mhaftarc/pcb_project_mh/docs/plytkamh.pdf

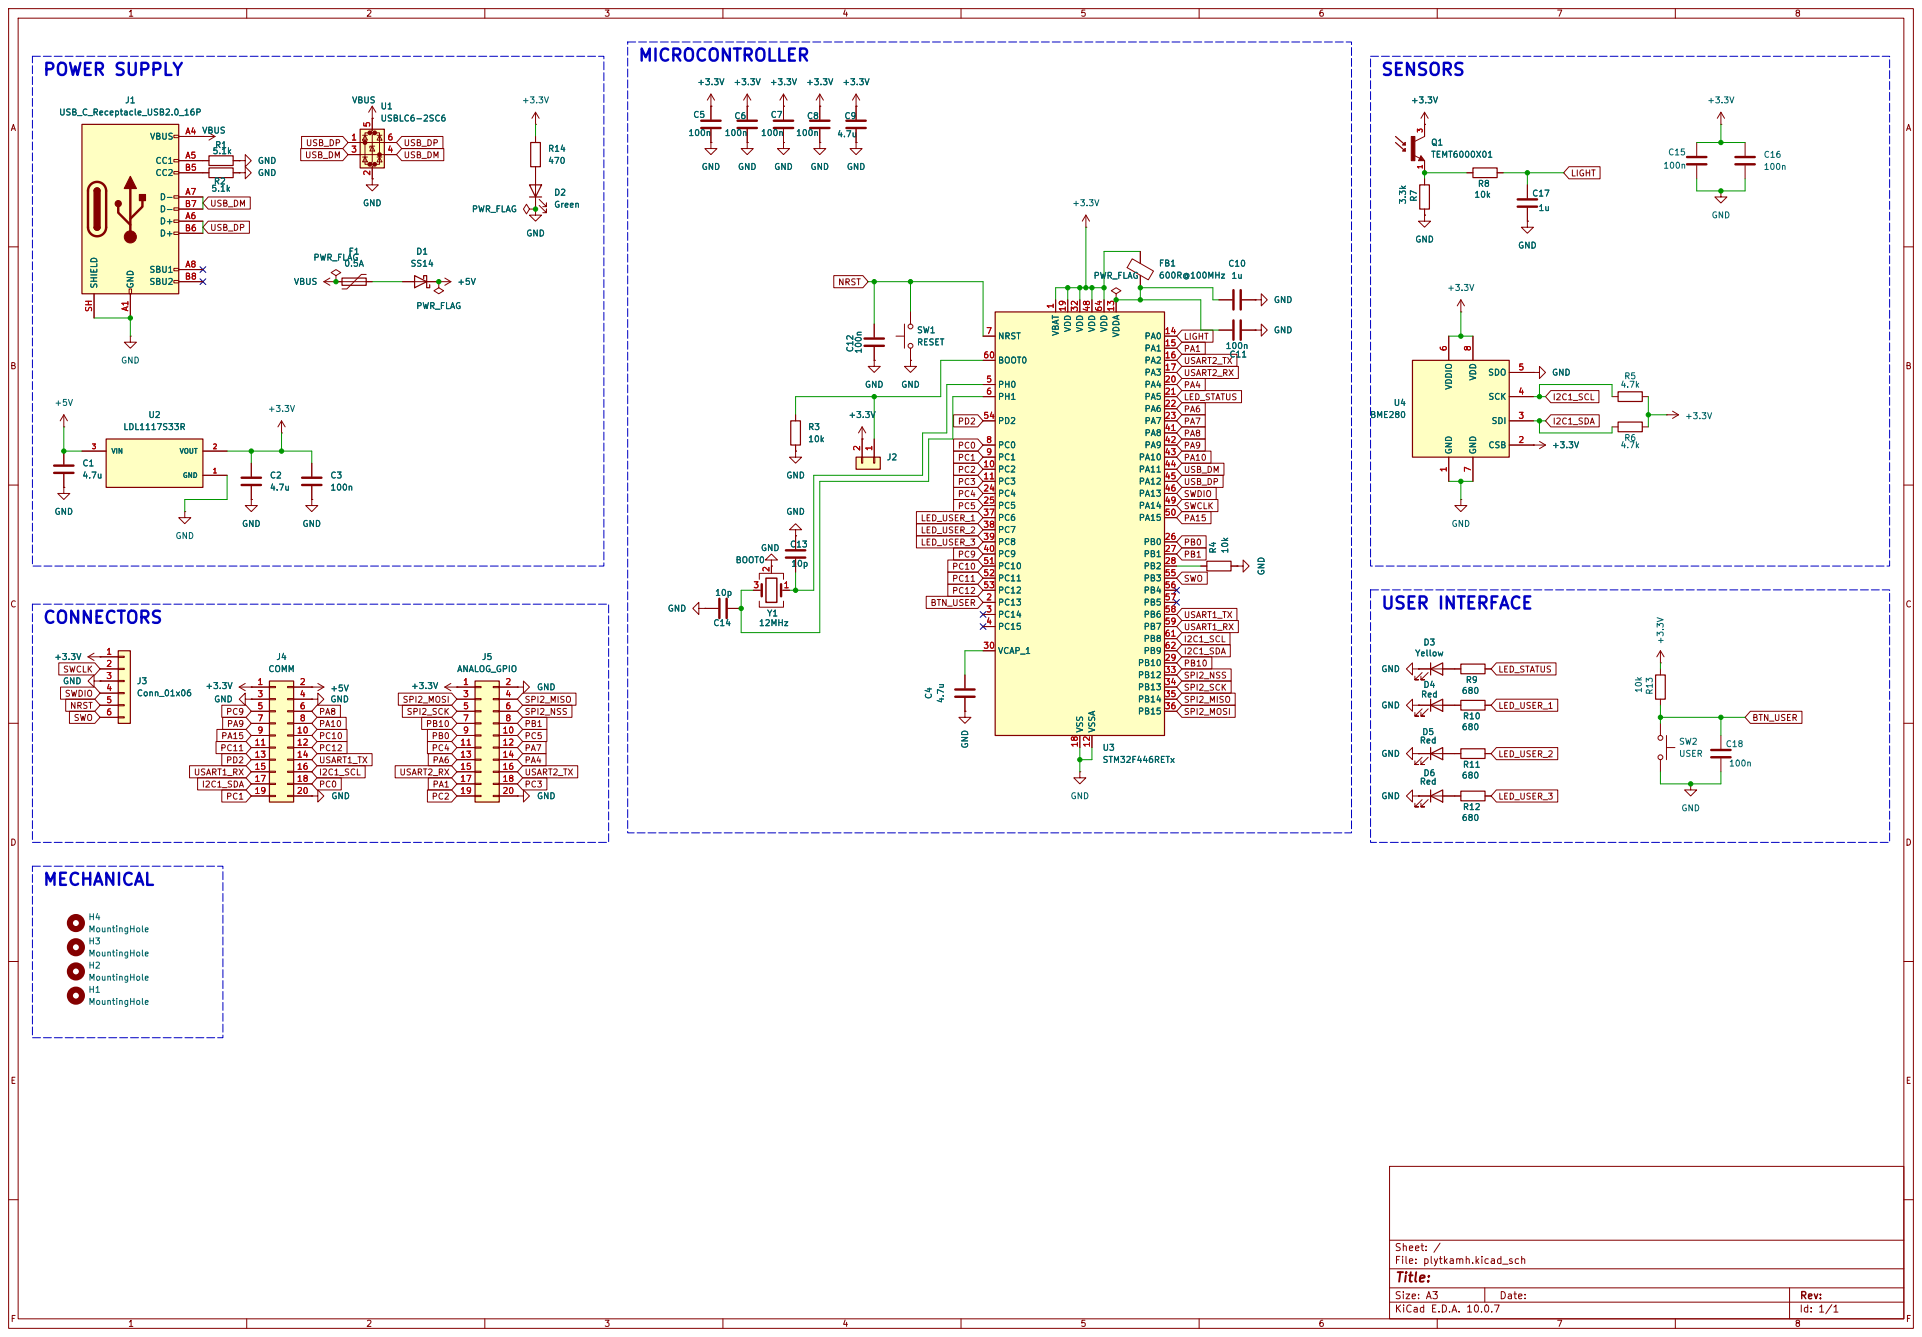
[picture p4: page 1]

Size: A3 | Rev: | F Date:
KiCad E.D.A. 10.0.7 | Id: 1/1
