mhaftarc/pcb_project_mh/plytkamh/plytkamh.kicad_pcb

## KiCad design plytkamh/plytkamh.kicad_pcb (2026-10-28)

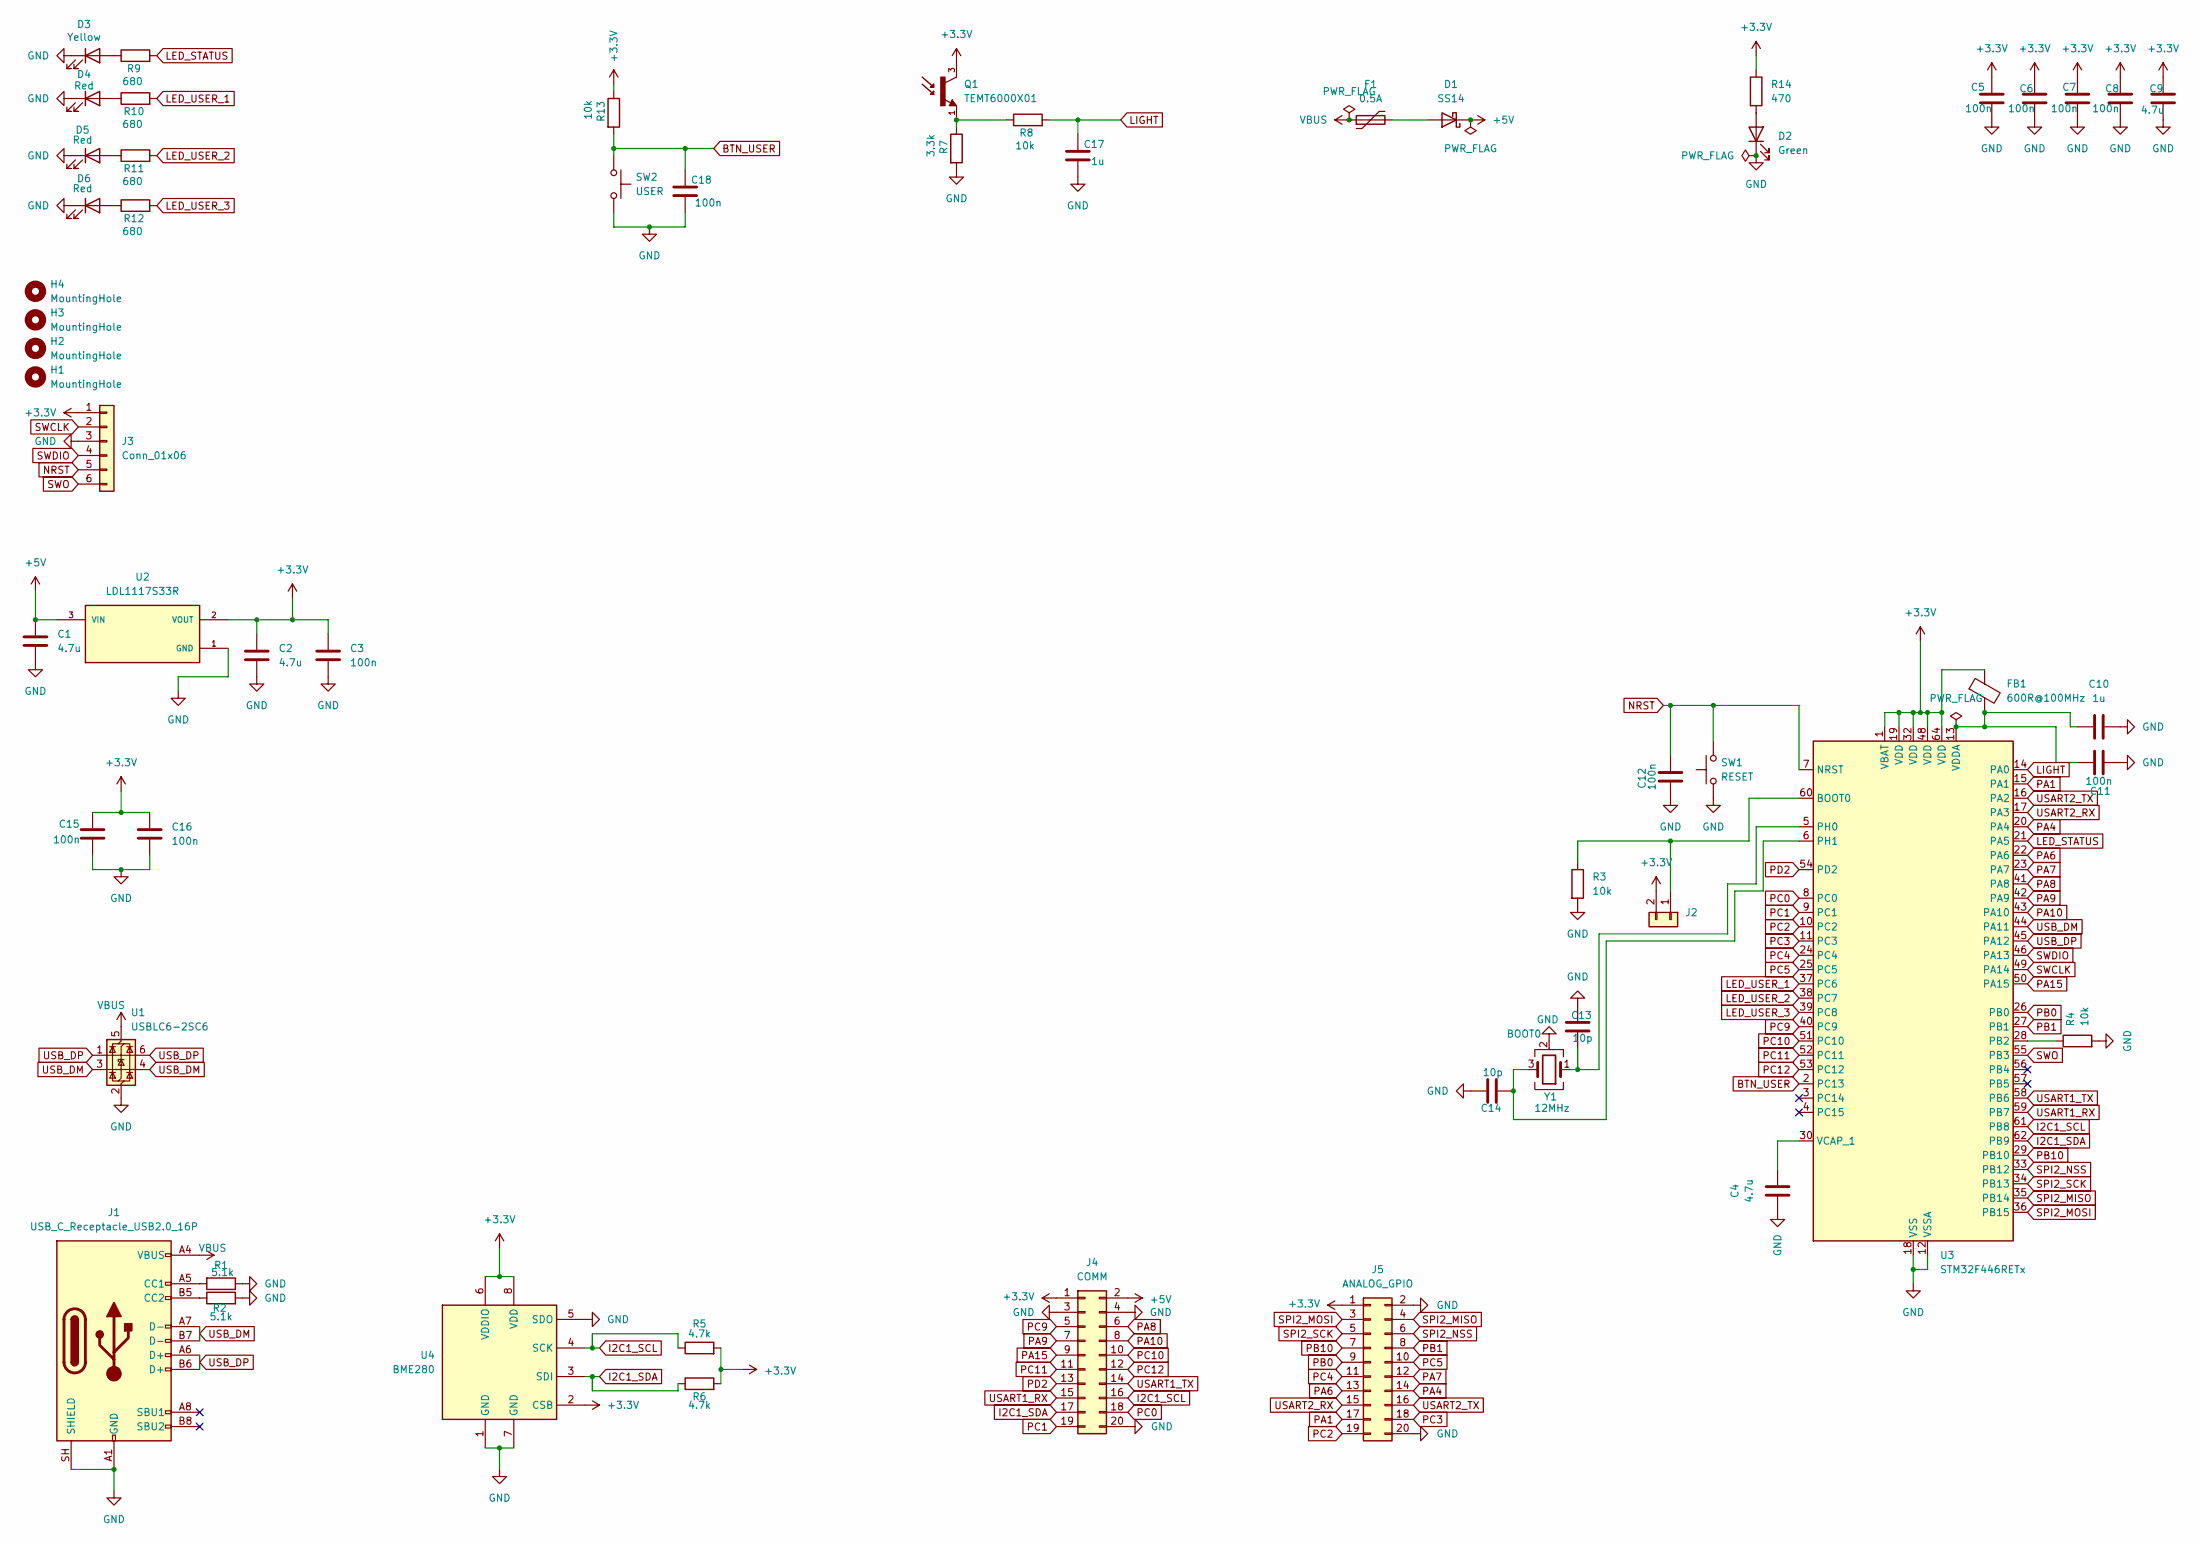
[picture p5: schematic plytkamh.kicad_sch]

Parts:
C1, C2, C4, C9: 4.7u; C_0603_1608Metric
C3, C5, C6, C7, C8, C11, C12, C15, C16, C18: 100n; C_0603_1608Metric
C10, C17: 1u; C_0603_1608Metric
C13, C14: 10p; C_0603_1608Metric
D1: SS14; D_SMA
D2: Green; LED_0603_1608Metric
D3: Yellow; LED_0603_1608Metric
D4, D5, D6: Red; LED_0603_1608Metric
F1: 0.5A; Fuse_1812_4532Metric
FB1: 600R@100MHz; L_0603_1608Metric
H1, H2, H3, H4: MountingHole; MountingHole_3.2mm_M3
J1: USB_C_Receptacle_USB2.0_16P; USB_C_Receptacle_GCT_USB4105-xx-A_16P_TopMnt_Horizontal
J2: BOOT0; PinHeader_1x02_P2.54mm_Vertical
J3: Conn_01x06; PinHeader_1x06_P2.54mm_Vertical
J4: COMM; PinHeader_2x10_P2.54mm_Vertical
J5: ANALOG_GPIO; PinHeader_2x10_P2.54mm_Vertical
Q1: TEMT6000X01; TRANS_TEMT6000X01; PARTREV 1.9
R1, R2: 5.1k; R_0603_1608Metric
R3, R4, R8, R13: 10k; R_0603_1608Metric
R5, R6: 4.7k; R_0603_1608Metric
R7: 3.3k; R_0603_1608Metric
R9, R10, R11, R12: 680; R_0603_1608Metric
R14: 470; R_0603_1608Metric
SW1: RESET; SW_PUSH_6mm
SW2: USER; SW_PUSH_6mm
U1: USBLC6-2SC6; SOT-23-6
U2: LDL1117S33R; SOT-223; PARTREV 7
U3: STM32F446RETx; LQFP-64_10x10mm_P0.5mm
U4: BME280; Bosch_LGA-8_2.5x2.5mm_P0.65mm_ClockwisePinNumbering
Y1: 12MHz; Crystal_SMD_3225-4Pin_3.2x2.5mm

Connections:
+3.3V: C2.1, C3.1, C5.1, C6.1, C7.1, C8.1, C9.1, C15.2, C16.2, FB1.1, J2.2, J3.1, J4.1, J5.1, Q1.3, R5.2, R6.2, R13.1, R14.1, U2.2 (VOUT), U2.4 (VOUT), U3.1 (VBAT), U3.19 (VDD), U3.32 (VDD), U3.48 (VDD), U3.64 (VDD), U4.2 (CSB), U4.6 (VDDIO), U4.8 (VDD)
+5V: C1.1, D1.1 (K), J4.2, U2.3 (VIN)
BTN_USER: C18.1, R13.2, SW2.1, U3.2 (PC13)
GND: C1.2, C2.2, C3.2, C4.1, C5.2, C6.2, C7.2, C8.2, C9.2, C10.2, C11.2, C12.2, C13.2, C14.2, C15.1, C16.1, C17.2, C18.2, D2.1 (K), D3.1 (K), D4.1 (K), D5.1 (K), D6.1 (K), J1.A1 (GND), J1.A12 (GND), J1.B1 (GND), J1.B12 (GND), J1.SH (SHIELD), J3.3, J4.3, J4.4, J4.20, J5.2, J5.20, R1.1, R2.2, R3.2, R4.2, R7.2, SW1.1, SW2.2, U1.2 (GND), U2.1 (GND), U3.12 (VSSA), U3.18 (VSS), U3.31 (VSS), U3.47 (VSS), U3.63 (VSS), U4.1 (GND), U4.5 (SDO), U4.7 (GND), Y1.2 (G), Y1.4 (G)
I2C1_SCL: J4.16, R5.1, U3.61 (PB8), U4.4 (SCK)
I2C1_SDA: J4.17, R6.1, U3.62 (PB9), U4.3 (SDI)
LED_STATUS: R9.2, U3.21 (PA5)
LED_USER_1: R10.2, U3.37 (PC6)
LED_USER_2: R11.2, U3.38 (PC7)
LED_USER_3: R12.2, U3.39 (PC8)
LIGHT: C17.1, R8.2, U3.14 (PA0)
NRST: C12.1, J3.5, SW1.2, U3.7 (NRST)
unnamed: D1.2 (A), F1.2
unnamed: D2.2 (A), R14.2
unnamed: D3.2 (A), R9.1
unnamed: D4.2 (A), R10.1
unnamed: D5.2 (A), R11.1
unnamed: D6.2 (A), R12.1
unnamed: J1.A5 (CC1), R1.2
unnamed: J1.B5 (CC2), R2.1
unnamed: J2.1, R3.1, U3.60 (BOOT0)
unnamed: Q1.1, R7.1, R8.1
unnamed: R4.1, U3.28 (PB2)
unnamed: C13.1, U3.5 (PH0), Y1.1
unnamed: C14.1, U3.6 (PH1), Y1.3
unnamed: C4.2, U3.30 (VCAP_1)
unnamed: C10.1, C11.1, FB1.2, U3.13 (VDDA)
PA1: J5.17, U3.15 (PA1)
PA4: J5.14, U3.20 (PA4)
PA6: J5.13, U3.22 (PA6)
PA7: J5.12, U3.23 (PA7)
PA8: J4.6, U3.41 (PA8)
PA9: J4.7, U3.42 (PA9)
PA10: J4.8, U3.43 (PA10)
PA15: J4.9, U3.50 (PA15)
PB0: J5.9, U3.26 (PB0)
PB1: J5.8, U3.27 (PB1)
PB10: J5.7, U3.29 (PB10)
PC0: J4.18, U3.8 (PC0)
PC1: J4.19, U3.9 (PC1)
PC2: J5.19, U3.10 (PC2)
PC3: J5.18, U3.11 (PC3)
PC4: J5.11, U3.24 (PC4)
PC5: J5.10, U3.25 (PC5)
PC9: J4.5, U3.40 (PC9)
PC10: J4.10, U3.51 (PC10)
PC11: J4.11, U3.52 (PC11)
PC12: J4.12, U3.53 (PC12)
PD2: J4.13, U3.54 (PD2)
SPI2_MISO: J5.4, U3.35 (PB14)
SPI2_MOSI: J5.3, U3.36 (PB15)
SPI2_NSS: J5.6, U3.33 (PB12)
SPI2_SCK: J5.5, U3.34 (PB13)
SWCLK: J3.2, U3.49 (PA14)
SWDIO: J3.4, U3.46 (PA13)
SWO: J3.6, U3.55 (PB3)
USART1_RX: J4.15, U3.59 (PB7)
USART1_TX: J4.14, U3.58 (PB6)
USART2_RX: J5.15, U3.17 (PA3)
USART2_TX: J5.16, U3.16 (PA2)
USB_DM: J1.A7 (D-), J1.B7 (D-), U1.3 (I/O2), U1.4 (I/O2), U3.44 (PA11)
USB_DP: J1.A6 (D+), J1.B6 (D+), U1.1 (I/O1), U1.6 (I/O1), U3.45 (PA12)
VBUS: F1.1, J1.A4 (VBUS), J1.A9 (VBUS), J1.B4 (VBUS), J1.B9 (VBUS), U1.5 (VBUS)

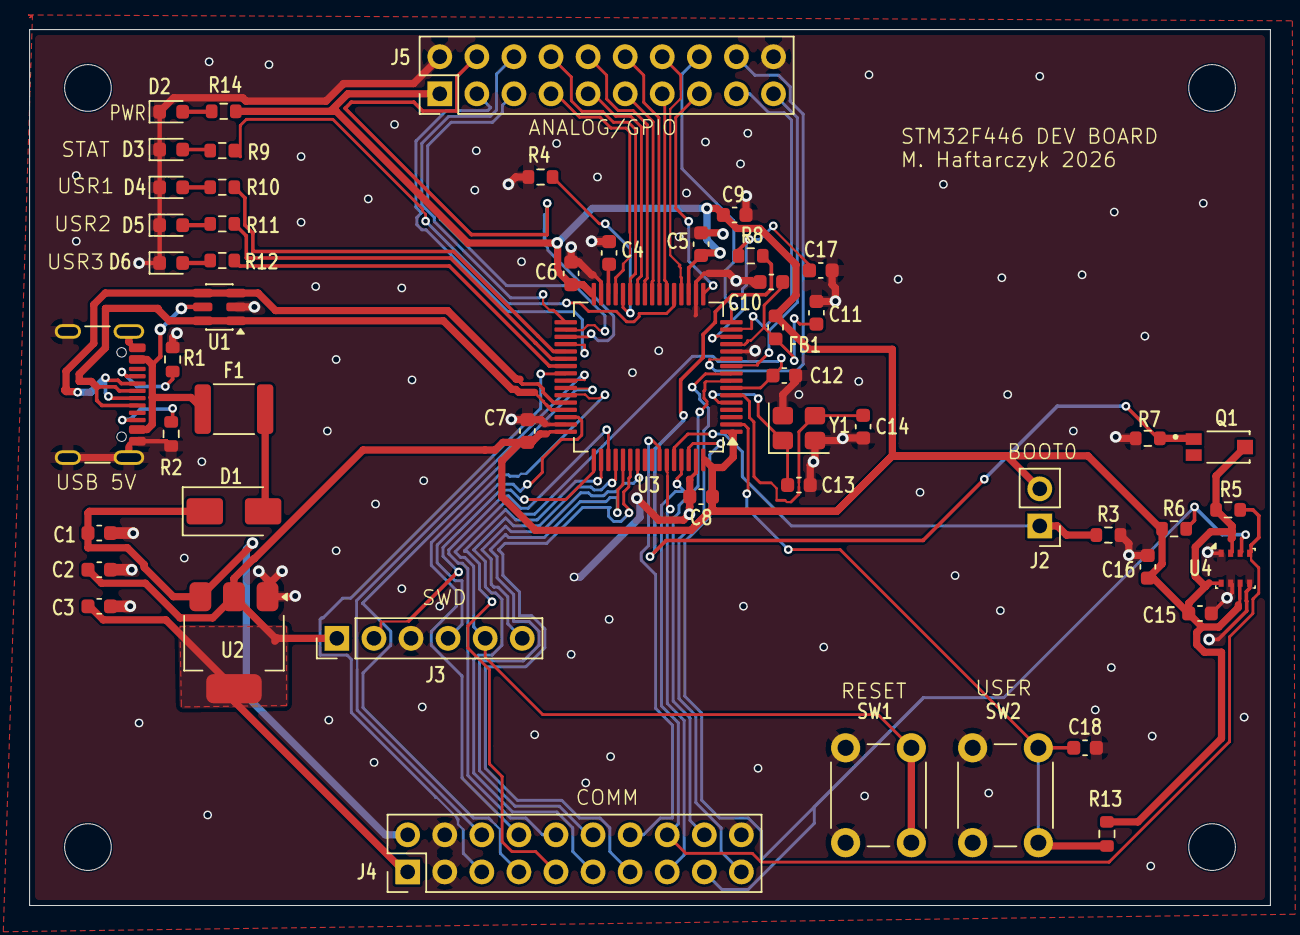
[picture p6: board plytkamh.kicad_pcb from above]

Board: 2 copper layers, 85.0 x 60.0 mm, 57 parts (0 on the bottom side), 63 nets.
