mhaftarc/pcb_project_mh/(commit log)

2026-10-19 schematic: power, MCU, sensors, Leds, buttons
    [plytkamh.kicad_pcb, plytkamh.kicad_sch]
2026-10-20 Finish schematic: J4/J5 headers, no-connects, VDDA PWR_FLAG, fix PH1 short
2026-10-20 Assign footprints
    [plytkamh.kicad_sch]
2026-10-22 component placement
    [plytkamh.kicad_pcb, plytkamh.kicad_sch]
2026-10-27 Before board resize
    [plytkamh.kicad_pcb]
2026-10-27 after resizing
    [plytkamh.kicad_pcb]
2026-10-27 J5 pin swap
    [plytkamh.kicad_sch]
2026-10-27 Remaped headers, routed the mcu and j4,j5, almost finished
    [plytkamh.kicad_pcb, plytkamh.kicad_sch]
2026-10-27 silkscreen left to do
    [plytkamh.kicad_pcb]
2026-10-28 final version of pcb, configured silkscreen, text and ready to generate gerber files
    [plytkamh.kicad_pcb]
2026-10-28 generated gerber files
    [plytkamh-B_Cu.gbr, plytkamh-B_Mask.gbr, plytkamh-B_Paste.gbr, plytkamh-B_Silkscreen.gbr, plytkamh-Edge_Cuts.gbr, plytkamh-F_Cu.gbr, plytkamh-F_Mask.gbr, plytkamh-F_Paste.gbr]
2026-10-28 docs: readme, pictures, schematic sections
    [plytkamh.kicad_sch]
2026-10-28 docs: add schematic link, fix language stats
